sahil-kolambkar/Buck-Converter/BoostWrap.jpeg

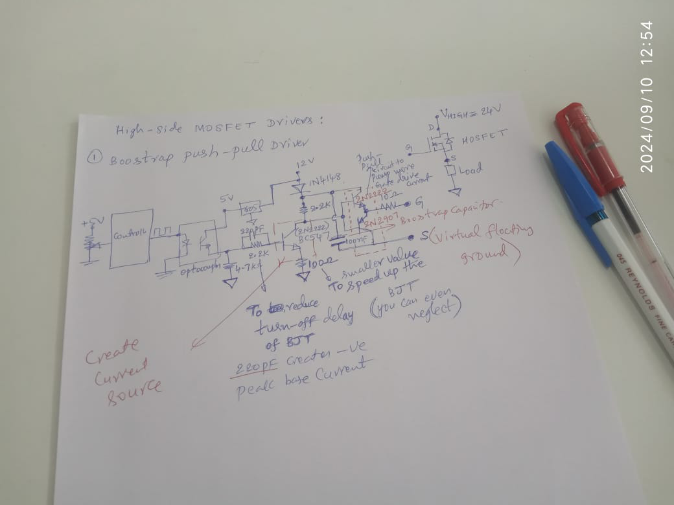
BoostWrap.jpeg
