sahil-kolambkar/Buck-Converter/Arduino PWM/IMG_20240924_110423.jpg

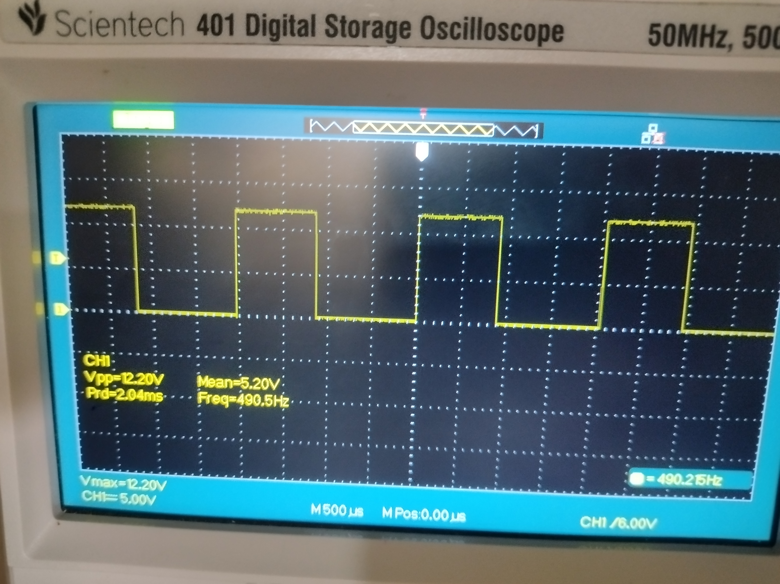
Arduino PWM/IMG_20240924_110423.jpg
