sahil-kolambkar/Buck-Converter/6N135.jpeg

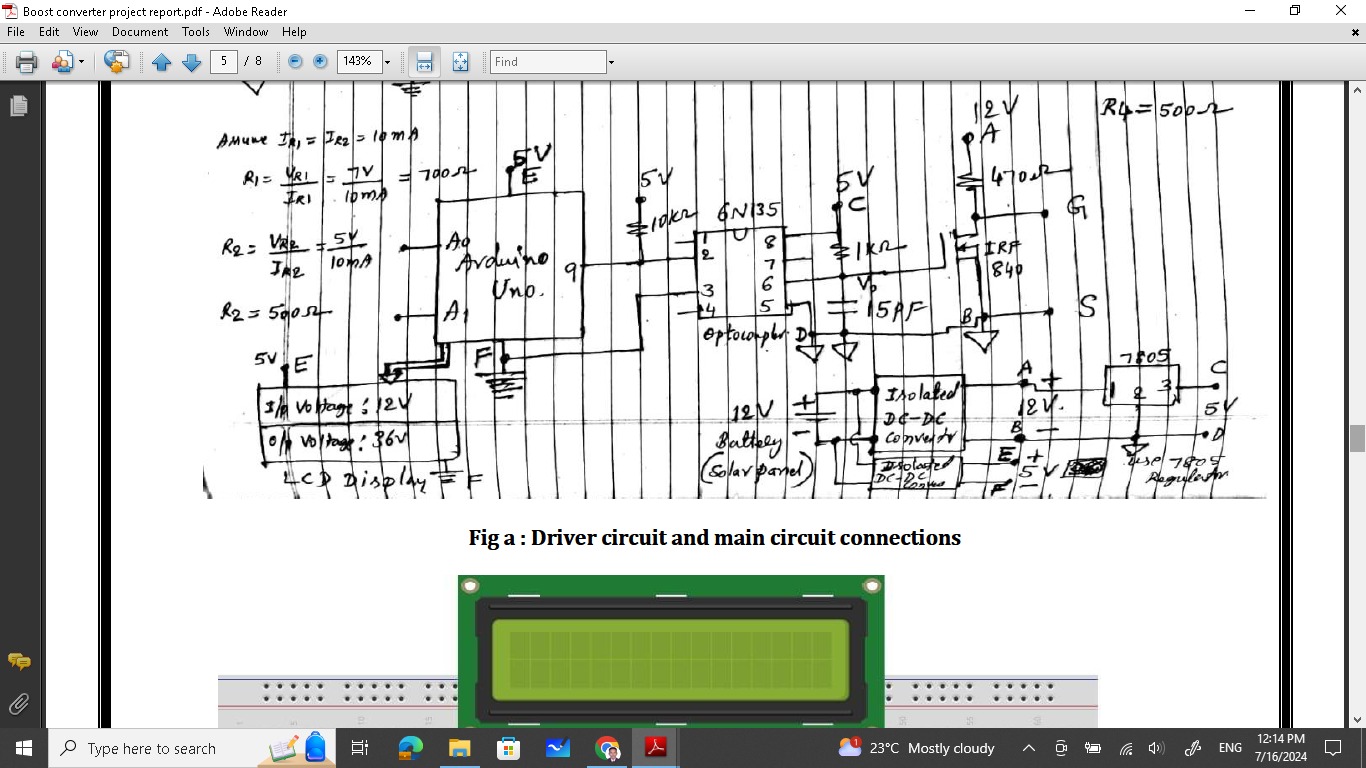
6N135.jpeg
