sahil-kolambkar/Buck-Converter/Arduino and Driver Circuit/IMG_20240926_135550.jpg

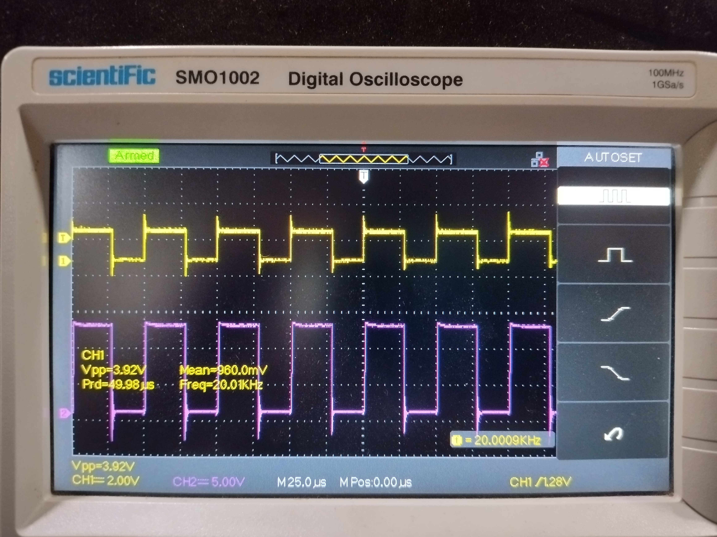
Arduino and Driver Circuit/IMG_20240926_135550.jpg
