sahil-kolambkar/Buck-Converter/Arduino and Driver Circuit/IMG_20240926_135603.jpg

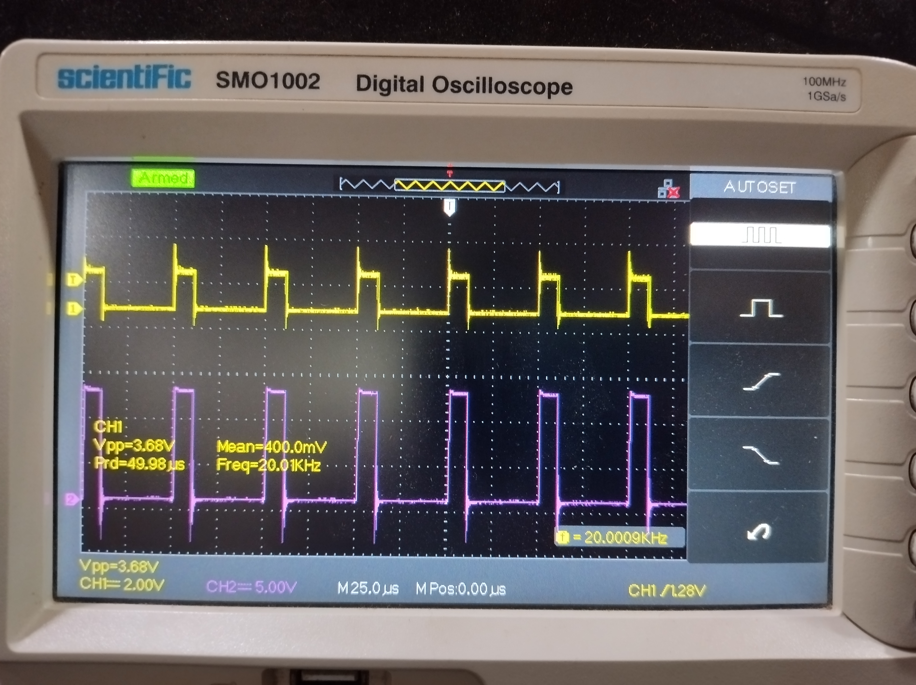
Arduino and Driver Circuit/IMG_20240926_135603.jpg
