sahil-kolambkar/Buck-Converter/Arduino and Optocoupler/IMG_20240925_153219.jpg

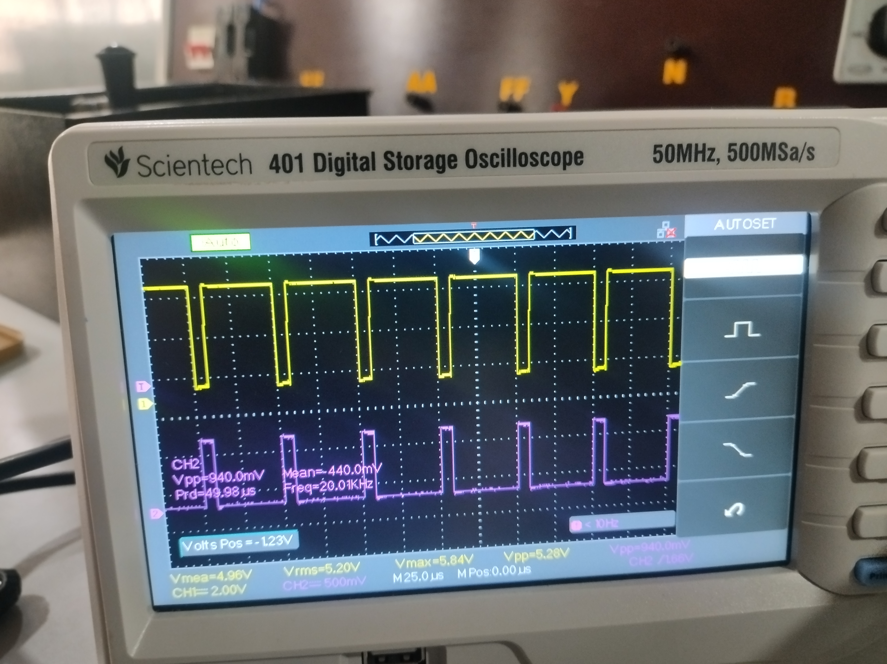
Arduino and Optocoupler/IMG_20240925_153219.jpg
