sahil-kolambkar/Buck-Converter/Arduino and Optocoupler/IMG_20240925_153220.jpg

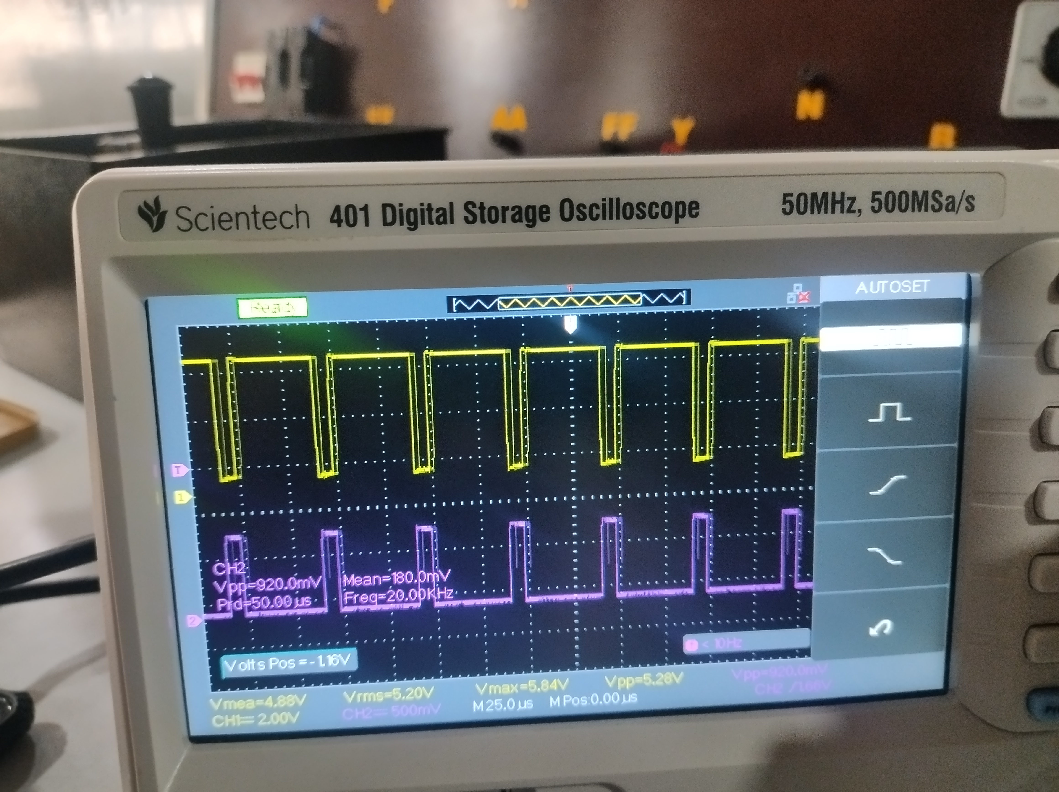
Arduino and Optocoupler/IMG_20240925_153220.jpg
