sahil-kolambkar/Buck-Converter/Arduino and Optocoupler/IMG_20240926_134709.jpg

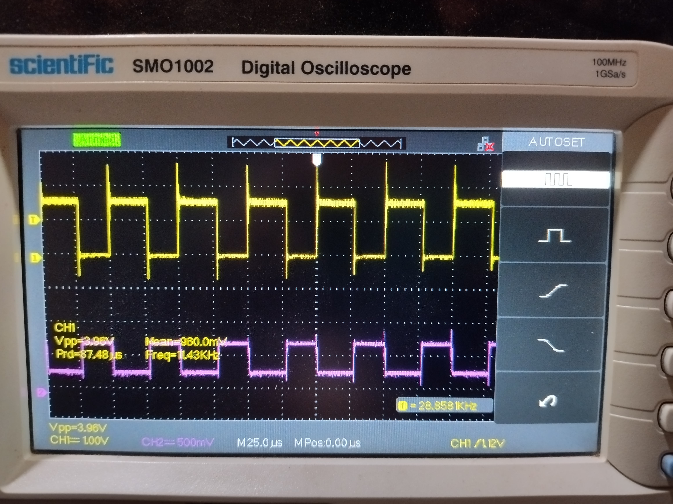
Arduino and Optocoupler/IMG_20240926_134709.jpg
