sahil-kolambkar/Buck-Converter/Arduino and Optocoupler/IMG_20240926_200013.jpg

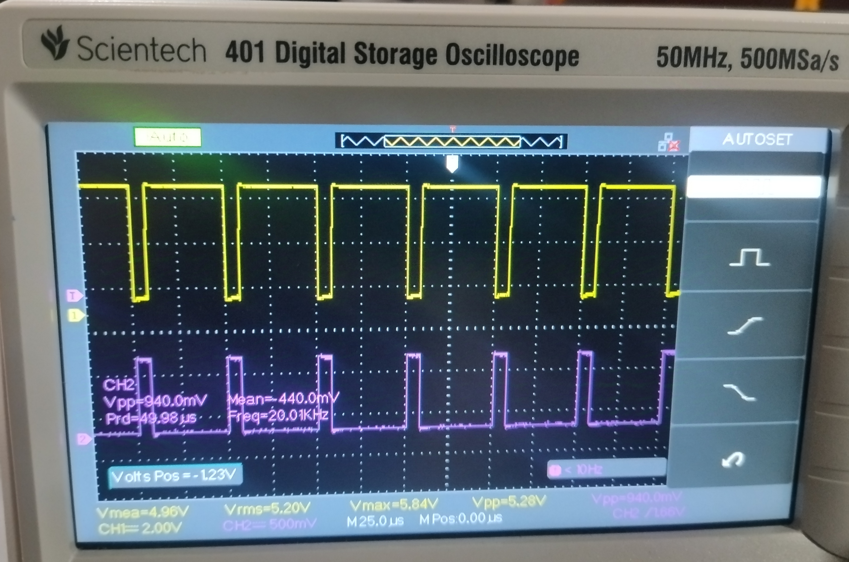
Arduino and Optocoupler/IMG_20240926_200013.jpg
