sahil-kolambkar/Buck-Converter/Arduino PWM/IMG_20240926_134033.jpg

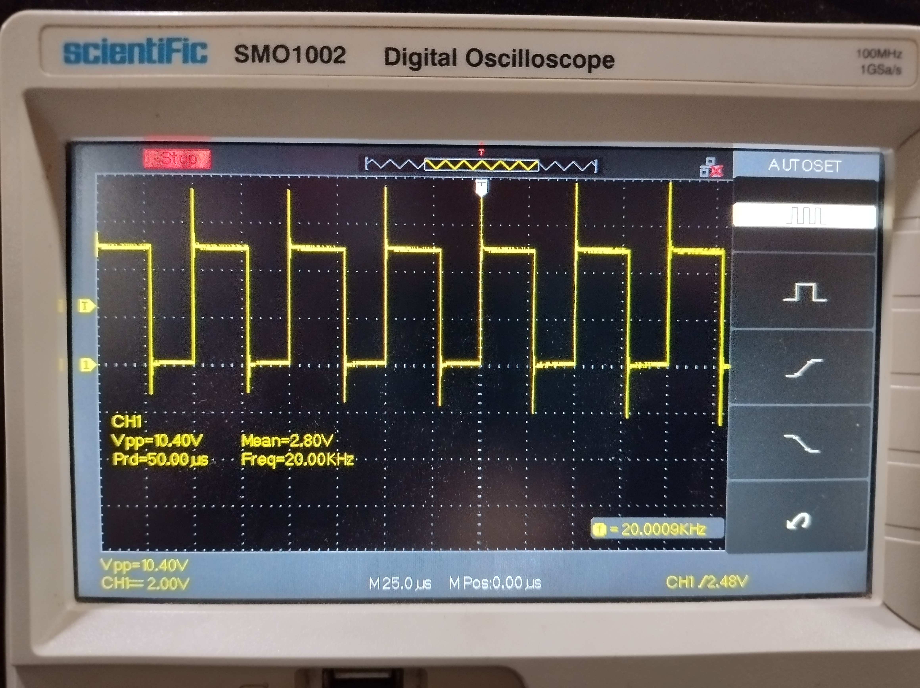
Arduino PWM/IMG_20240926_134033.jpg
