sahil-kolambkar/Buck-Converter/Arduino PWM/IMG_20240926_134053.jpg

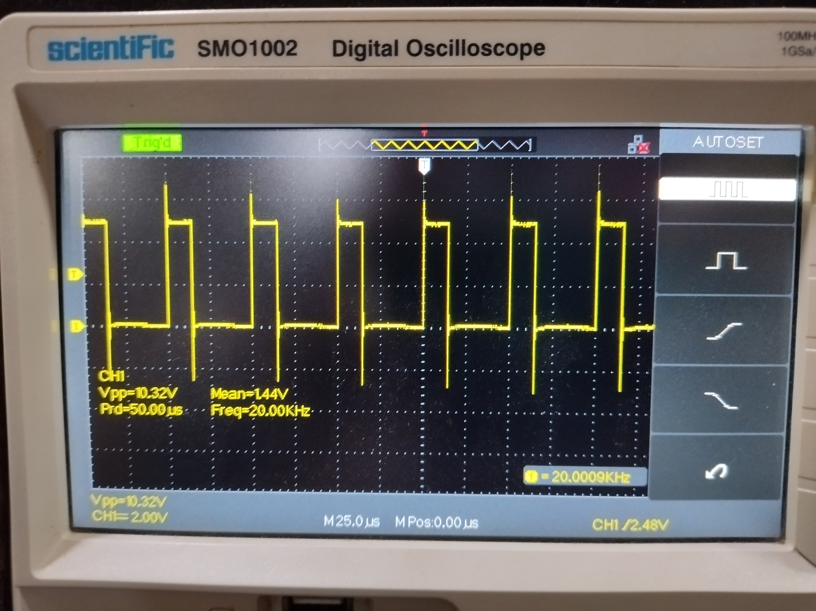
Arduino PWM/IMG_20240926_134053.jpg
