sahil-kolambkar/Buck-Converter/Buck.jpeg

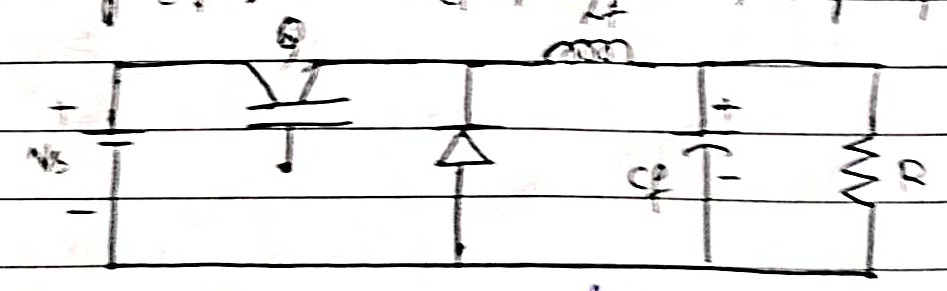
Buck.jpeg
