sahil-kolambkar/Buck-Converter/LTspice Simulation/Circuit.png

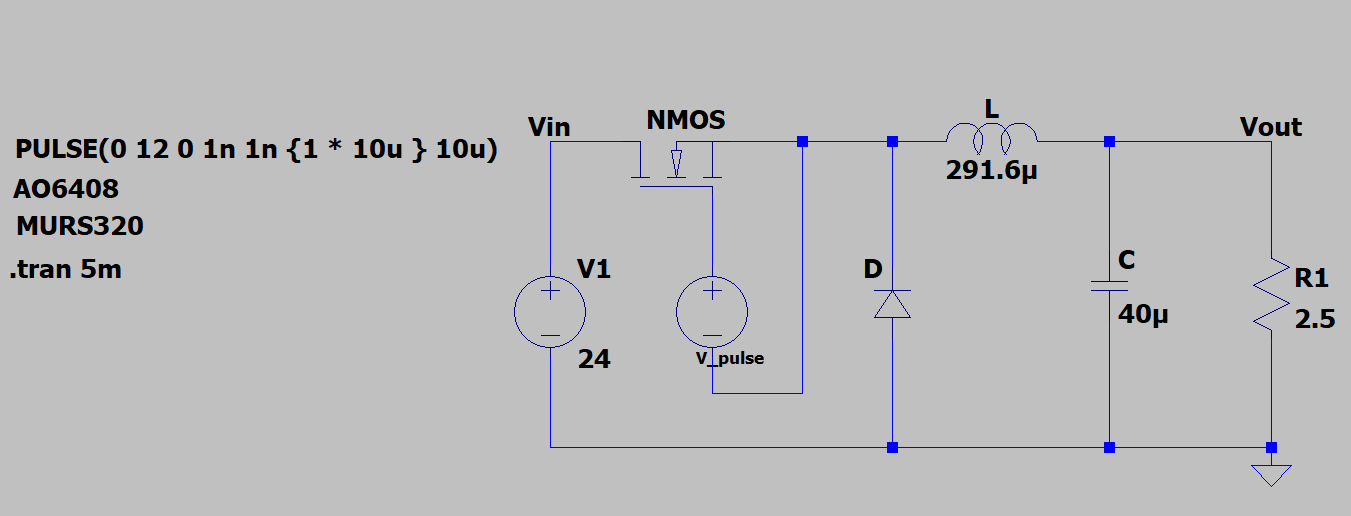
LTspice Simulation/Circuit.png
