sahil-kolambkar/Buck-Converter/LTspice Simulation/Vin.png

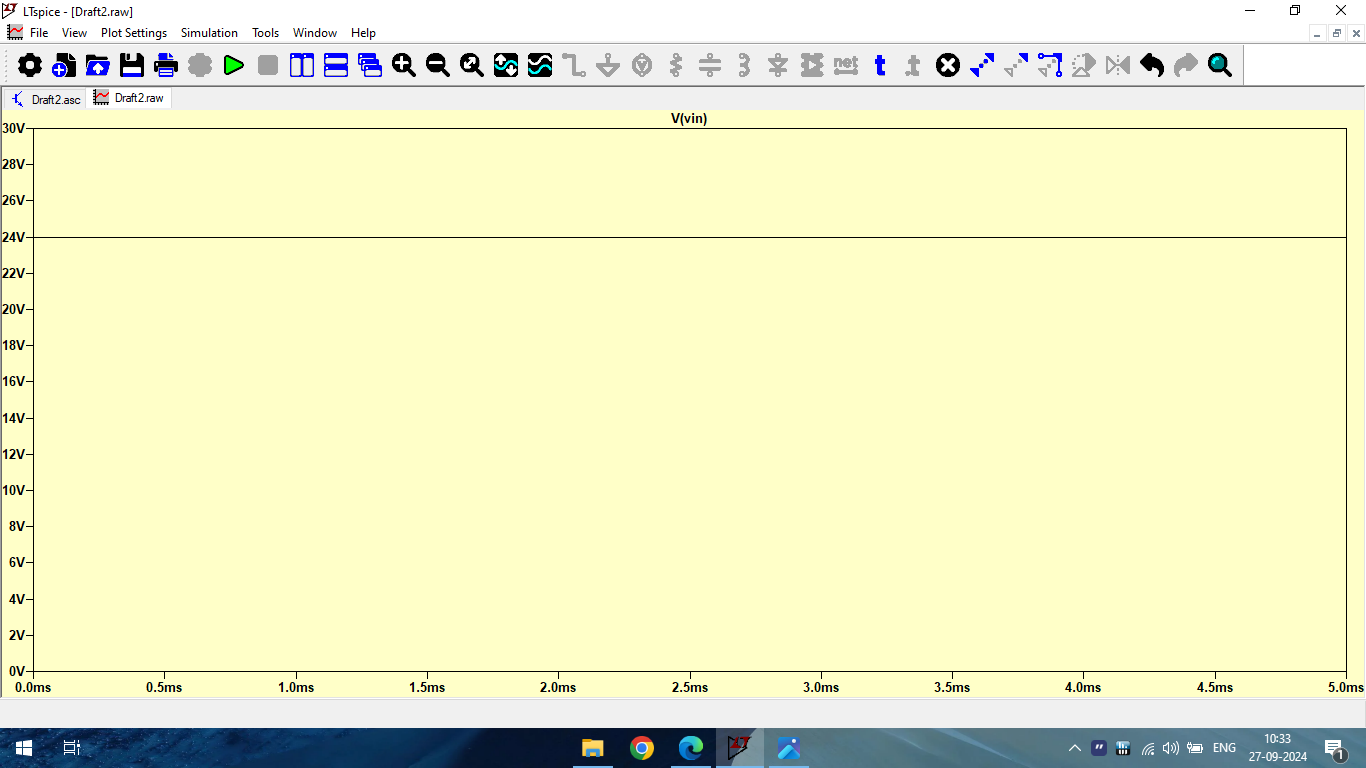
LTspice Simulation/Vin.png
