sahil-kolambkar/Buck-Converter/List of components.docx

Sl. No. | Component | | Quantity

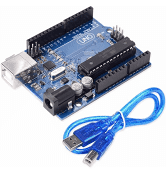
[picture p24: figure]
Arduino Uno R3 with Cable | Robu.in

1 | Arduino Uno Board with cable | | 01

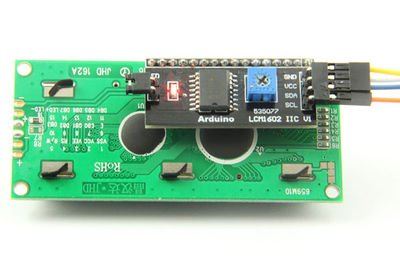
[picture p25: figure]
i2c LCD Module for arduino

2 | I2C LCD (Serial LCD) | | 01

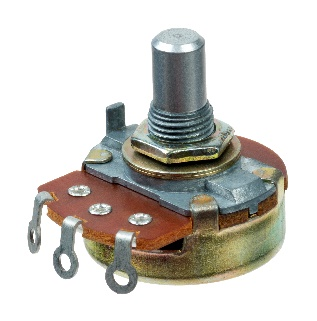
[picture p26: figure]
Potentiometer - Wikipedia

3 | Potentiometer (1k ohm) and (10k ohm) | | 02 each

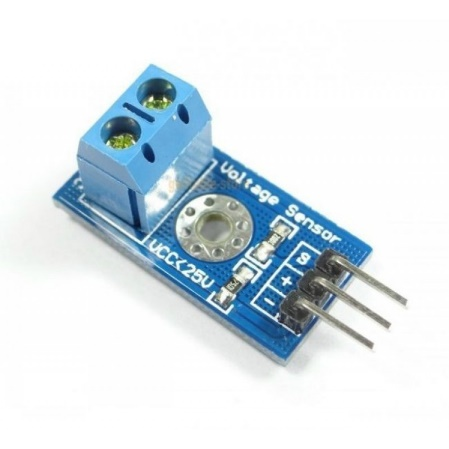
[picture p27: figure]

4 | Voltage sensor | | 01

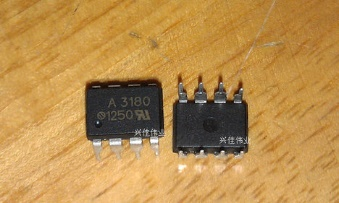
[picture p28: figure]

6 | A3180 Optocoupler | | 02
| 6N135 Optocoupler | | 02

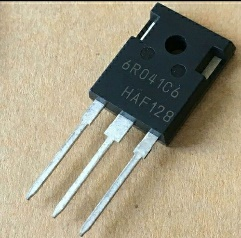
[picture p29: figure]
IPW60R041C6, For Industrial, Empire Electronics | ID: 22483259130

8 | MOSFET (IPW60R041C6) | | 02

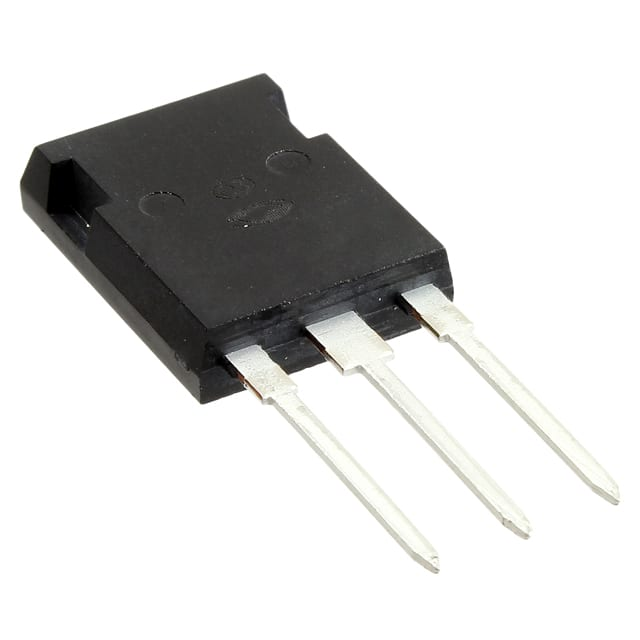
[picture p30: figure]
APT60DQ60BCTG Microchip Technology | Discrete Semiconductor Products | DigiKey

9 | Power Diode (APT60DQ60BCT(G)) | | 02
13 | Resistors | 300 ohm/300 Watt | 01
| | 100 ohm/5 Watt | 01
| | 47K ohm/Half Watt | 10
| | 1K ohm/Quarter Watt | 10
| | 100 ohm/Half Watt | 10
| | 200 ohm/Half Watt | 10
| | 100 ohm/5 Watt | 02
| | 10 ohm / Half watt | 05
| | 1.2 kohm/Half watt | 05
| | 1 kohm/Half watt | 05
| | 10 kohm/Half watt | 05

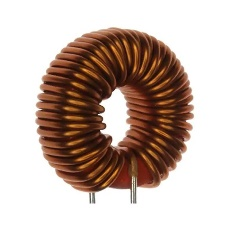
[picture p31: figure]
330uH 5.2A High Current Toroidal DIP Inductor

14 | Inductor | 115 mH @2A, @20kHz | 01

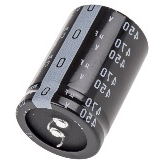
[picture p32: figure]

15 | Capacitor | 470 Micro Farad / 100V (Electrolytic) | 01
| | 0.00416 Micro Farad / 400V (Electrolytic) | 01
| | 22 Micro Farad/25V (Electrolytic) | 02
| | 100 nano Farad (Ceramic) | 02

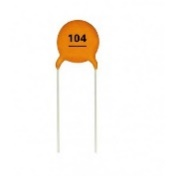
[picture p33: figure]

| | 1.1 Micro Farad (Ceramic) | 05

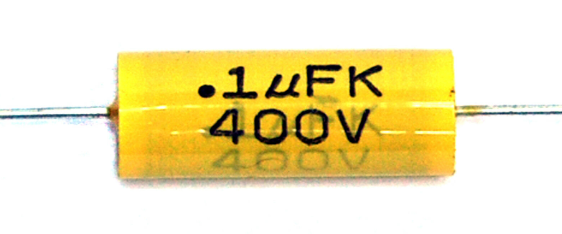
[picture p34: figure]

| | 1.1 micro Farad/400V (axial lead yellow color) | 01

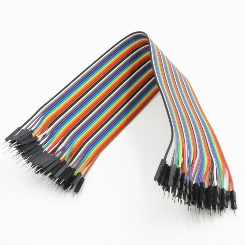
[picture p35: figure]
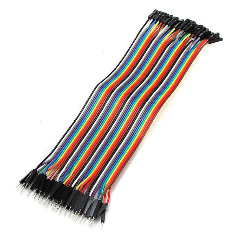
[picture p36: figure]
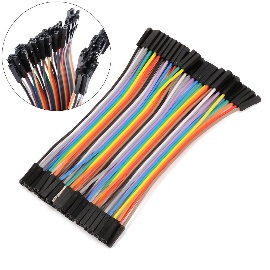
[picture p37: figure]

16 | Connecting wires (Male to Male, Male to Female, Female to Female)

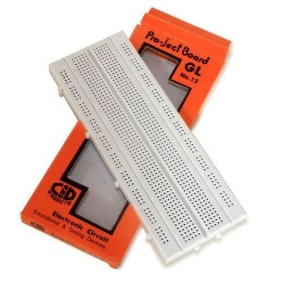
[picture p38: figure]

18 | Bread Boards | | 01

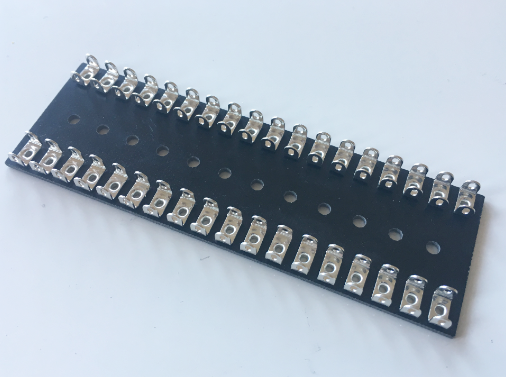
[picture p39: figure]

19 | Tag Board | | 01

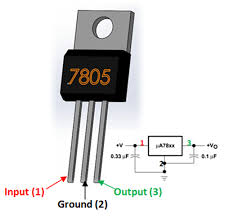
[picture p40: figure]

20 | 7805 IC | | 02
