sahil-kolambkar/Buck-Converter/Bill.xlsx

ITEM | Qnt | Price
A3180 Octocoupler | 1
GN135 Octocoupler | 1
MOSFET (IPW60R041C6) | 1 | 700
Power Diode (APT60DQ60BCT(G)) | 1
7805 IC | 2
Inductor 115 mH | 2 | 100+60 | 60 - sanketh
470 Micro Farad | 2
22 Micro Farad | 10 | 50
100 nano Farad | 10
Bread Board | 1
Tag Board | 2
Arduino Uno | 1
LCD i2c | 1 | 850 | 150 - sanketh
Voltage Sesnor | 1
1k POT | 2
10K POT | 2
Jumper Wires | 3
Resistor 100 ohm 5 Watt | 2 | 20 | sanketh
Solder Gun | 1 | 150 | sanketh
Capacitor 15pF | 10 | 10 | sanketh
NPN Transistor | 5 | 20 | sanketh
PNP Transistor | 5 | 20 | sanketh
CKL NPN |  |  | sanketh
CKL PNP |  | 70 | sanketh | Balance
CLIPS |  |  | sanketh | Sanket | 210 Rs | Jupiter 20 september
