sahil-kolambkar/Buck-Converter/Report/Print Schematic.jpg

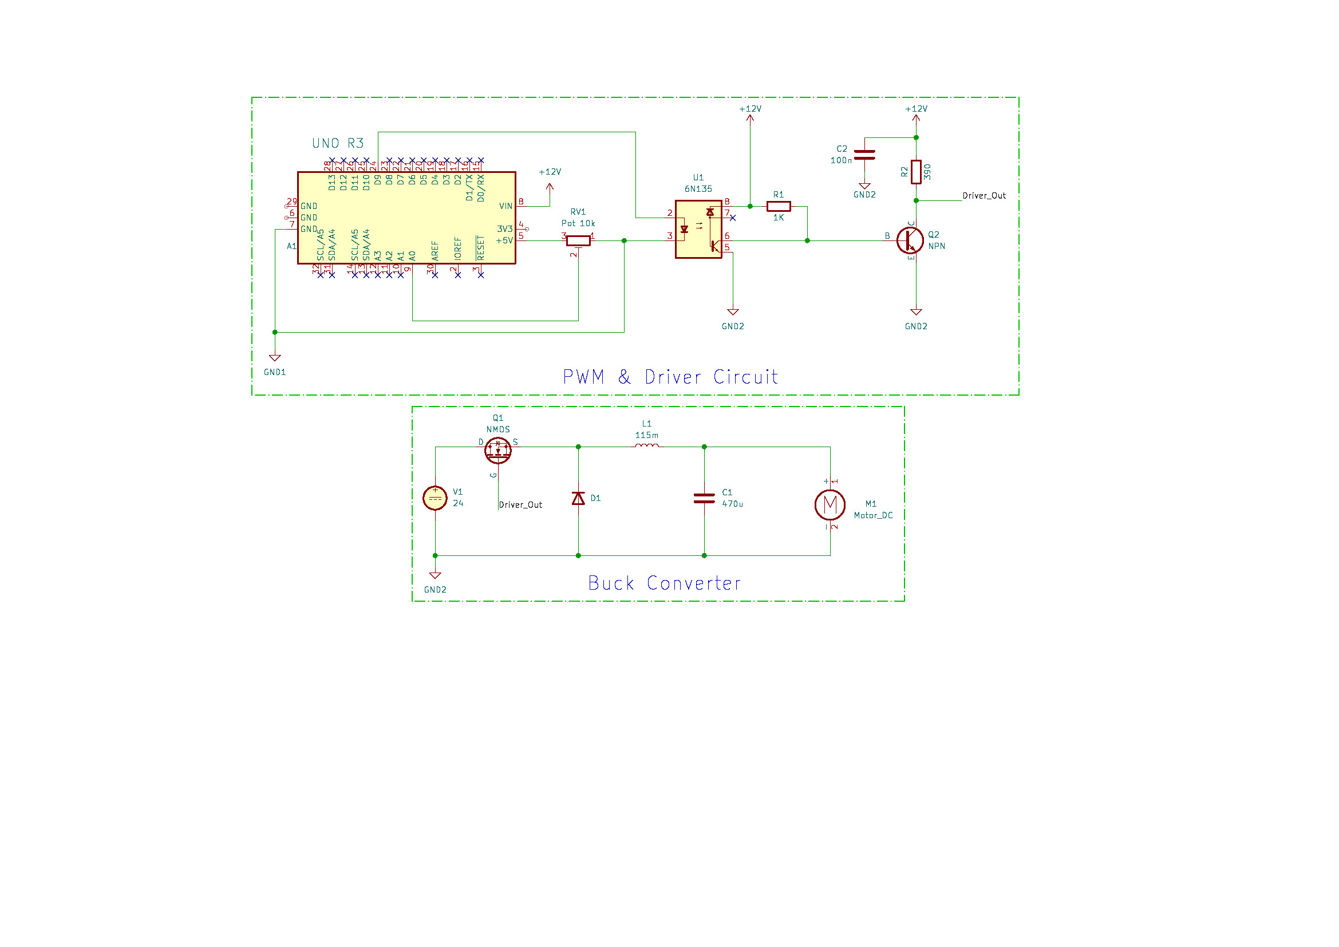
Report/Print Schematic.jpg
