sahil-kolambkar/Buck-Converter/Print Schematic.pdf

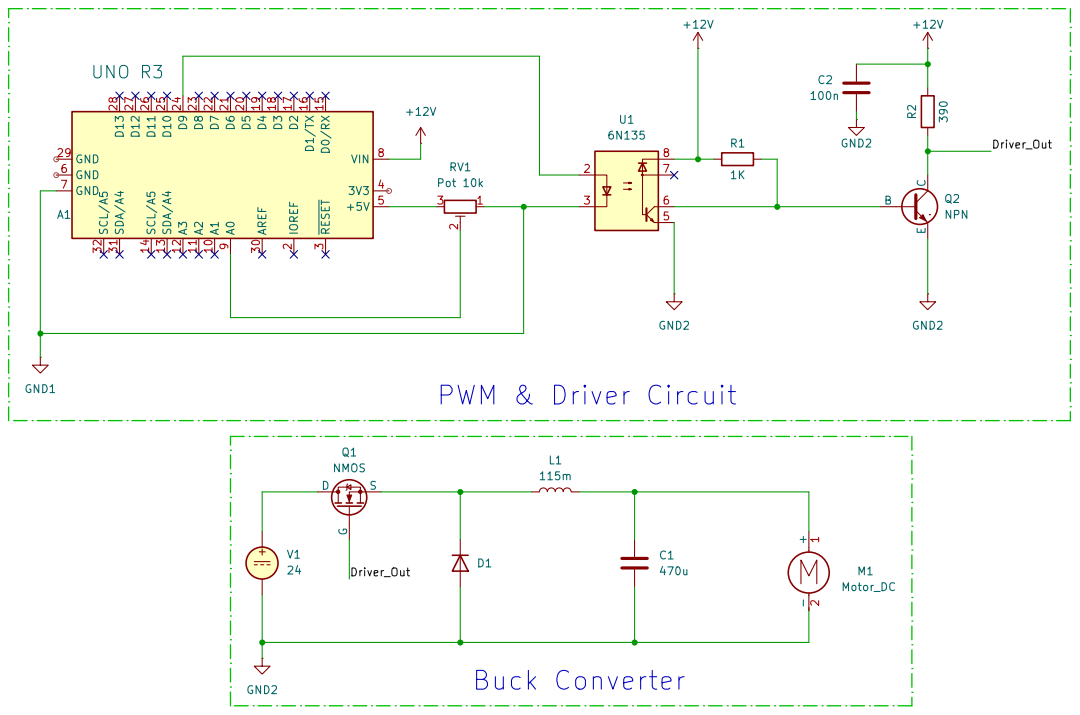
[picture p42: page 1]
