sahil-kolambkar/Buck-Converter/LTspice Simulation/Buck.asc

C: cap; 47µ
D: diode; MURS320
L: ind; 290µ
NMOS: nmos; AO6408
R1: res; 2.5
V1: voltage; 24
V_pulse: voltage; PULSE(0 12 0 1n 1n {1 * 10u } 10u)
Named nets: 0, Vout, Vin
.tran 5m
