sahil-kolambkar/Buck-Converter/LTspice Simulation/Draft2.asc

C: cap; 40µ
D: diode; MURS320
L: ind; 291.6µ
NMOS: nmos; AO6408
R1: res; 2.5
V1: voltage; 24
V_pulse: voltage; PULSE(0 12 0 1n 1n {1 * 10u } 10u)
Named nets: 0, Vout, Vin
.tran 5m
