sahil-kolambkar/Buck-Converter/kiCad/Buck.kicad_sch

## KiCad design kiCad/Buck.kicad_sch (2024-09-29)

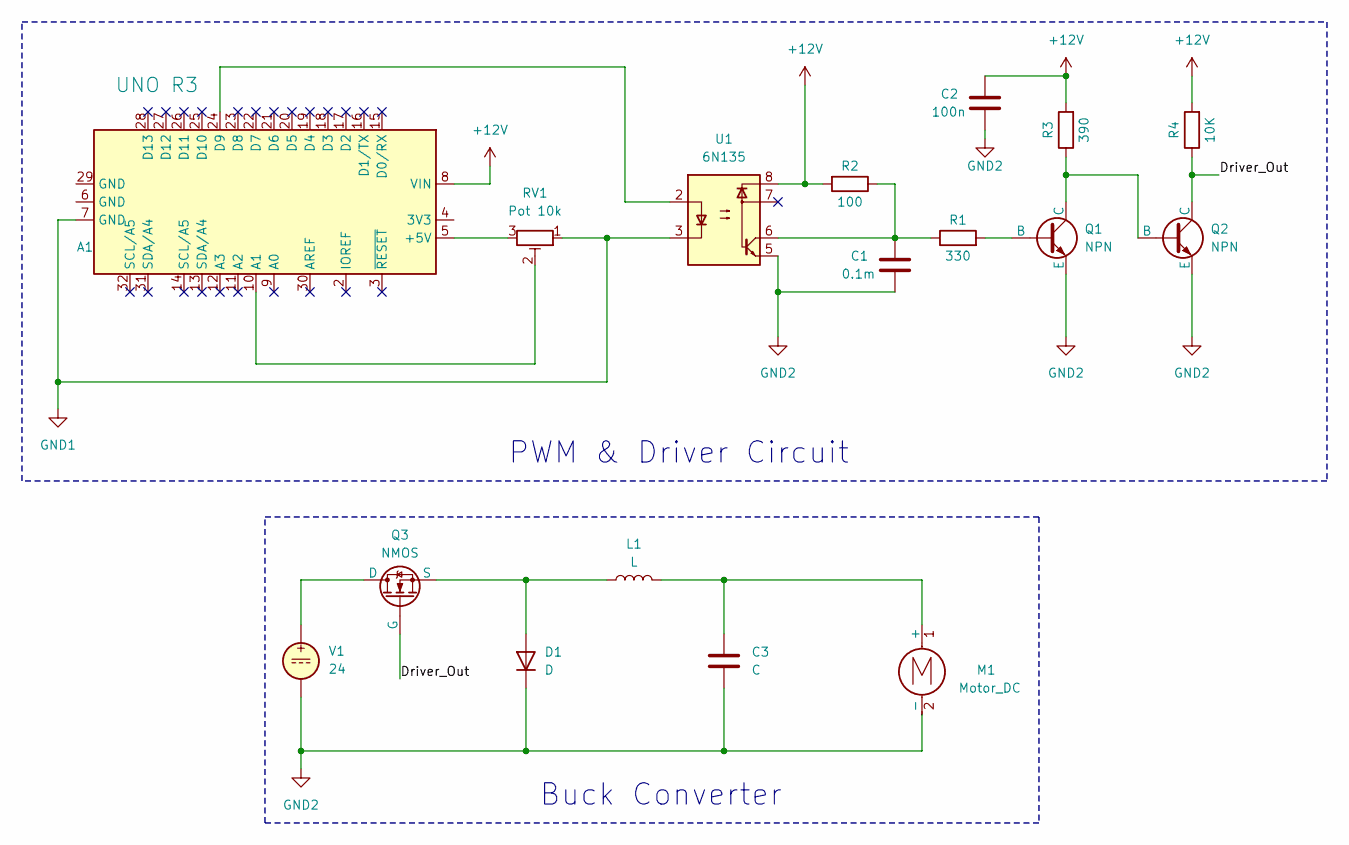
[picture p43: schematic Buck.kicad_sch]

Parts:
A1: UNO R3; Arduino_UNO_R3
C1: 0.1m
C2: 100n
C3: C
D1: D
L1: L
M1: Motor_DC
Q1, Q2: NPN
Q3: NMOS
R1: 330
R2: 100
R3: 390
R4: 10K
RV1: Pot 10k
U1: 6N135; DIP-8_W7.62mm
V1: 24

Connections:
+12V: A1.8 (VIN), C2.1, R2.2, R3.2, R4.2, U1.8
Driver_Out: Q2.1 (C), Q3.2 (G), R4.1
GND1: A1.7 (GND), RV1.1, U1.3
GND2: C1.2, C2.2, C3.2, D1.1 (K), M1.2 (-), Q1.3 (E), Q2.3 (E), U1.5, V1.2
unnamed: A1.5 (+5V), RV1.3
unnamed: A1.10 (A1), RV1.2
unnamed: A1.24 (D9), U1.2
unnamed: C1.1, R1.1, R2.1, U1.6
unnamed: C3.1, L1.2, M1.1 (+)
unnamed: D1.2 (A), L1.1, Q3.3 (S)
unnamed: Q1.1 (C), Q2.2 (B), R3.1
unnamed: Q1.2 (B), R1.2
unnamed: Q3.1 (D), V1.1

Notes on the sheet:
Buck Converter
PWM & Driver Circuit
